JulianDomingo/pcbs/README.md

# pcbs
Public PCB files for my keyboard projects!
