JulianDomingo/pcbs/ai03/pngs/traces.png

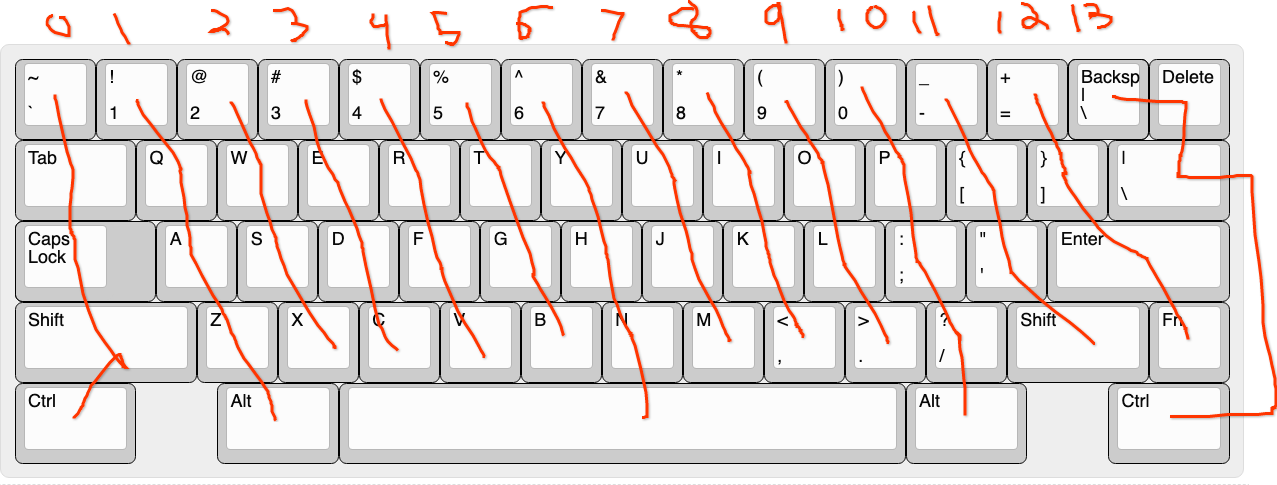
ai03/pngs/traces.png
