JulianDomingo/pcbs/popstar-rp2040/Produce_DanZhi.SMT_Snapshot.Bottom.5732099A_Y2.SMT02303201172969.png

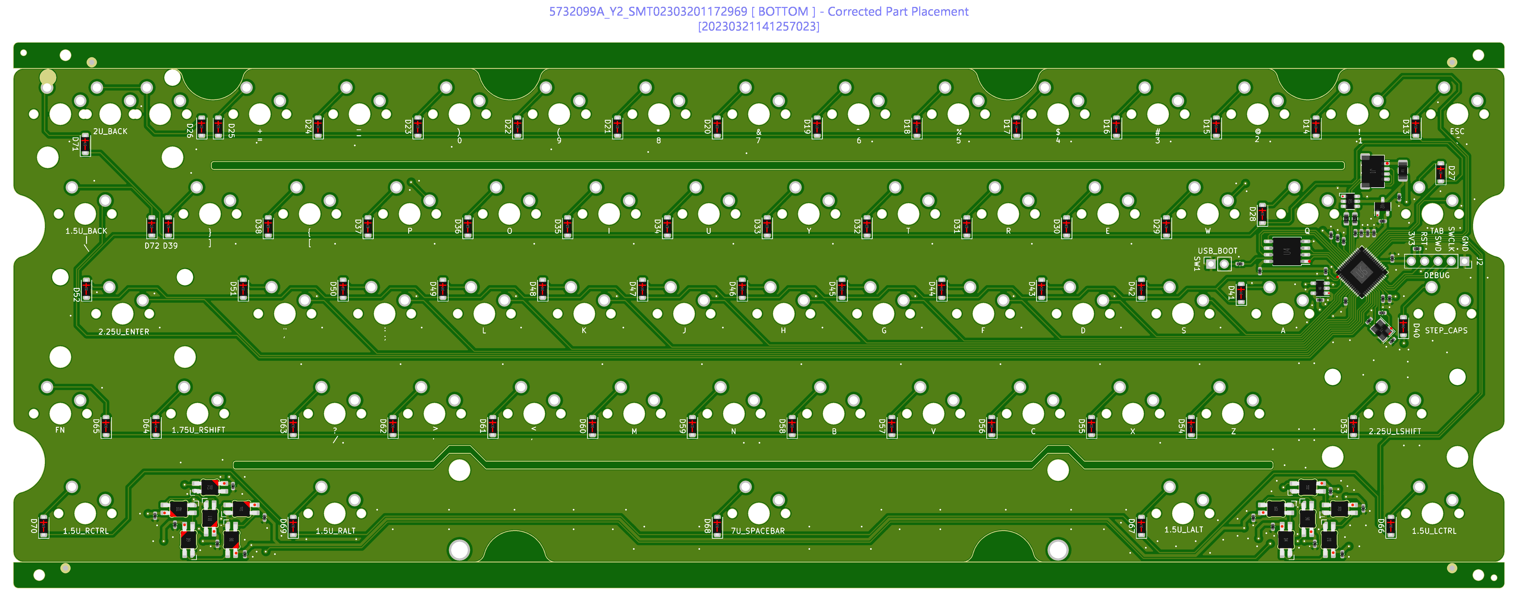
popstar-rp2040/Produce_DanZhi.SMT_Snapshot.Bottom.5732099A_Y2.SMT02303201172969.png
