JulianDomingo/pcbs/popstar-rp2040/Snowball0.png

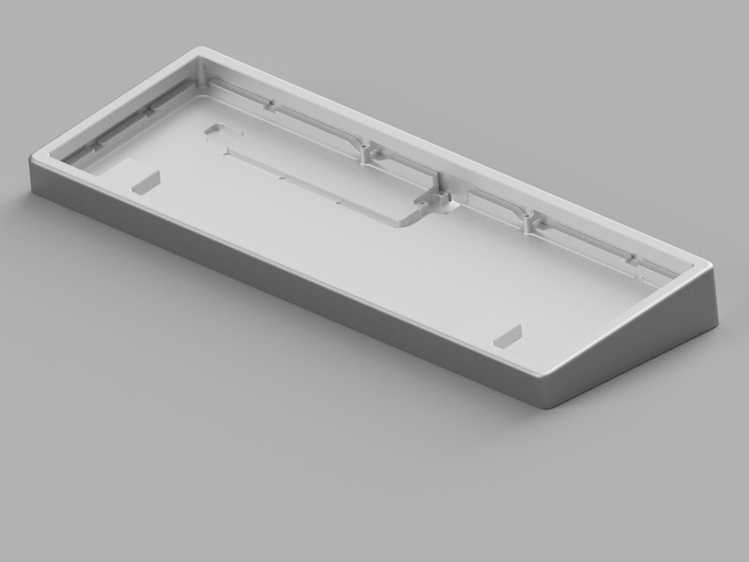
popstar-rp2040/Snowball0.png
