JulianDomingo/pcbs/popstar-rp2040/Snowball1.png

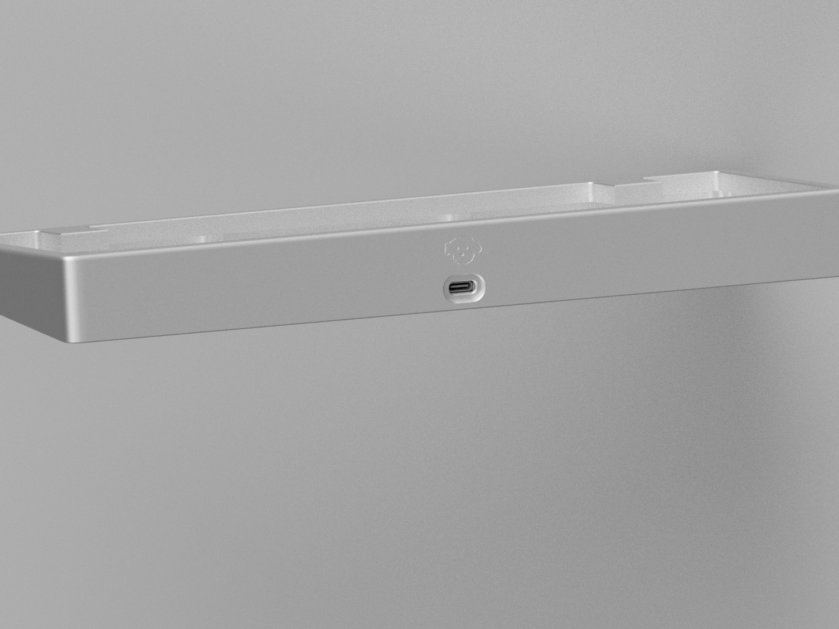
popstar-rp2040/Snowball1.png
