JulianDomingo/pcbs/parts-list/popstar/link.md

[Google Spreadsheet](https://docs.google.com/spreadsheets/d/1XqGUWrDkp94JxGkHds8K1SceW7hPjPMKtQx_E4DiOJU)
