JulianDomingo/pcbs/dxf/engraving.dxf

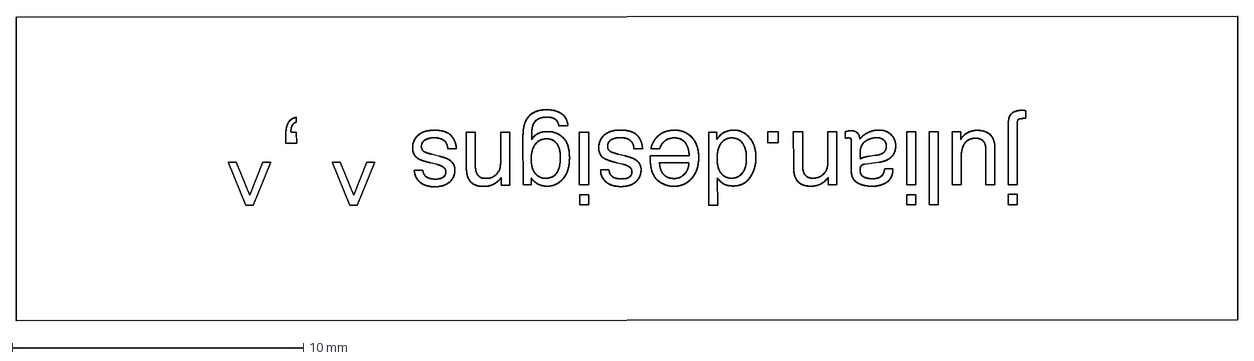
[picture p5: CAD file, 2023-03-19]
dxf/engraving.dxf
42.0 x 10.5 mm
