JulianDomingo/pcbs/popstar-rp2040/uyg.dxf

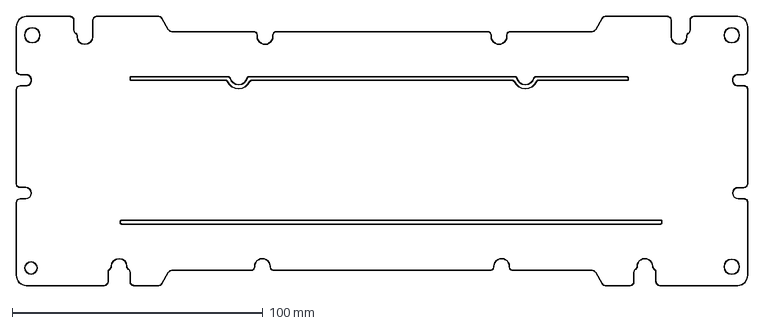
[picture p6: CAD file, 2023-06-08]
popstar-rp2040/uyg.dxf
291.4 x 107.2 mm
