JulianDomingo/pcbs/dxf/bottom_flex_cuts.dxf

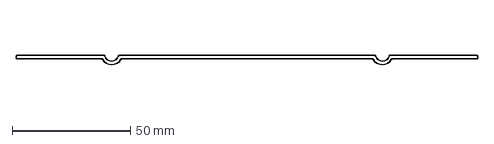
[picture p7: CAD file, 2023-03-12]
dxf/bottom_flex_cuts.dxf
195.0 x 3.97 mm
