JulianDomingo/pcbs/popstar-rp2040/plateless_v4.1_final.dxf

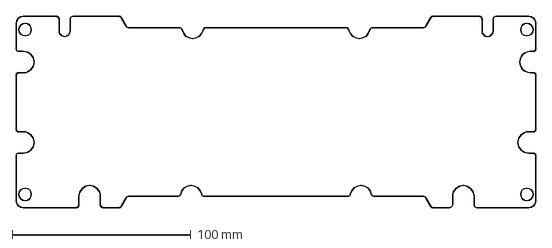
[picture p8: CAD file, 2023-06-08]
popstar-rp2040/plateless_v4.1_final.dxf
290.7 x 107.0 mm
