JulianDomingo/pcbs/dxf/pcb_outer_edges.dxf

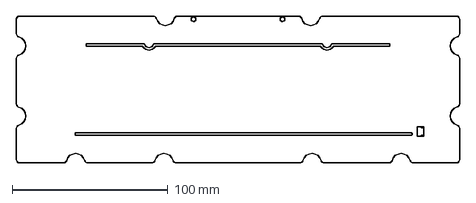
[picture p9: CAD file, 2023-03-12]
dxf/pcb_outer_edges.dxf
284.7 x 94.2 mm
