JulianDomingo/pcbs/popstar-rp2040/popstar_plateless_actual_final.dxf

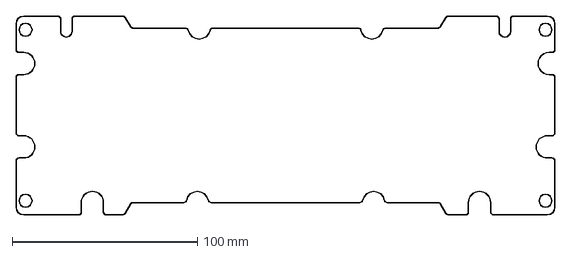
[picture p10: CAD file, 2023-06-08]
popstar-rp2040/popstar_plateless_actual_final.dxf
290.7 x 107.2 mm
