JulianDomingo/pcbs/dxf/pcb_silkscreen.dxf

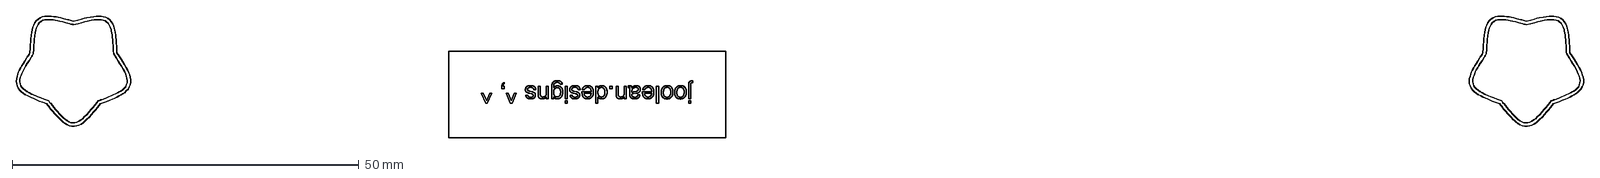
[picture p11: CAD file, 2023-03-10]
dxf/pcb_silkscreen.dxf
226.1 x 17.6 mm
