JulianDomingo/pcbs/popstar-rp2040/no_projections_outline.dxf

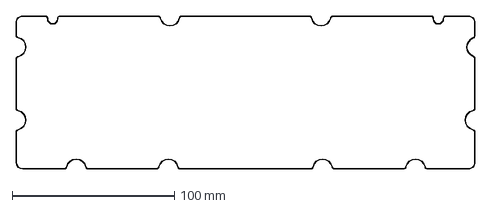
[picture p12: CAD file, 2023-06-08]
popstar-rp2040/no_projections_outline.dxf
282.7 x 94.2 mm
