JulianDomingo/pcbs/popstar-rp2040/popstar_v4.0_plate_outline_final_prod.dxf

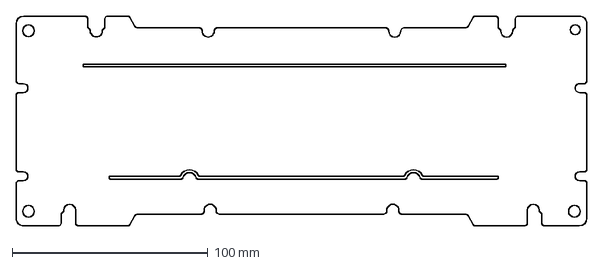
[picture p13: CAD file, 2023-06-08]
popstar-rp2040/popstar_v4.0_plate_outline_final_prod.dxf
291.4 x 107.2 mm
