JulianDomingo/pcbs/popstar-rp2040/popstar_plateless_vertically_aligned.dxf

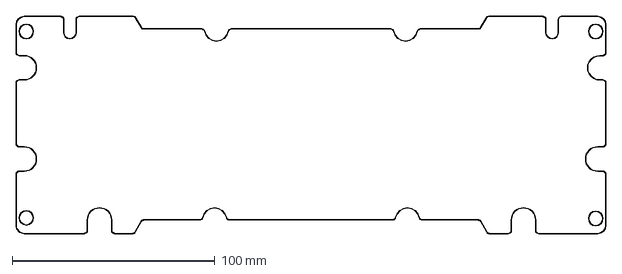
[picture p14: CAD file, 2023-06-08]
popstar-rp2040/popstar_plateless_vertically_aligned.dxf
290.7 x 107.0 mm
