JulianDomingo/pcbs/(list of files, cad)

Other CAD files:
popstar-rp2040/f.silkscreen_no_border.dxf
popstar-rp2040/f.silkscreen_popstarv2.dxf
popstar-rp2040/f.silkscreen_v2.dxf
