JulianDomingo/pcbs/popstar-rp2040/popstar.kicad_pcb

## KiCad design popstar-rp2040/popstar.kicad_pcb (2023-03-16)

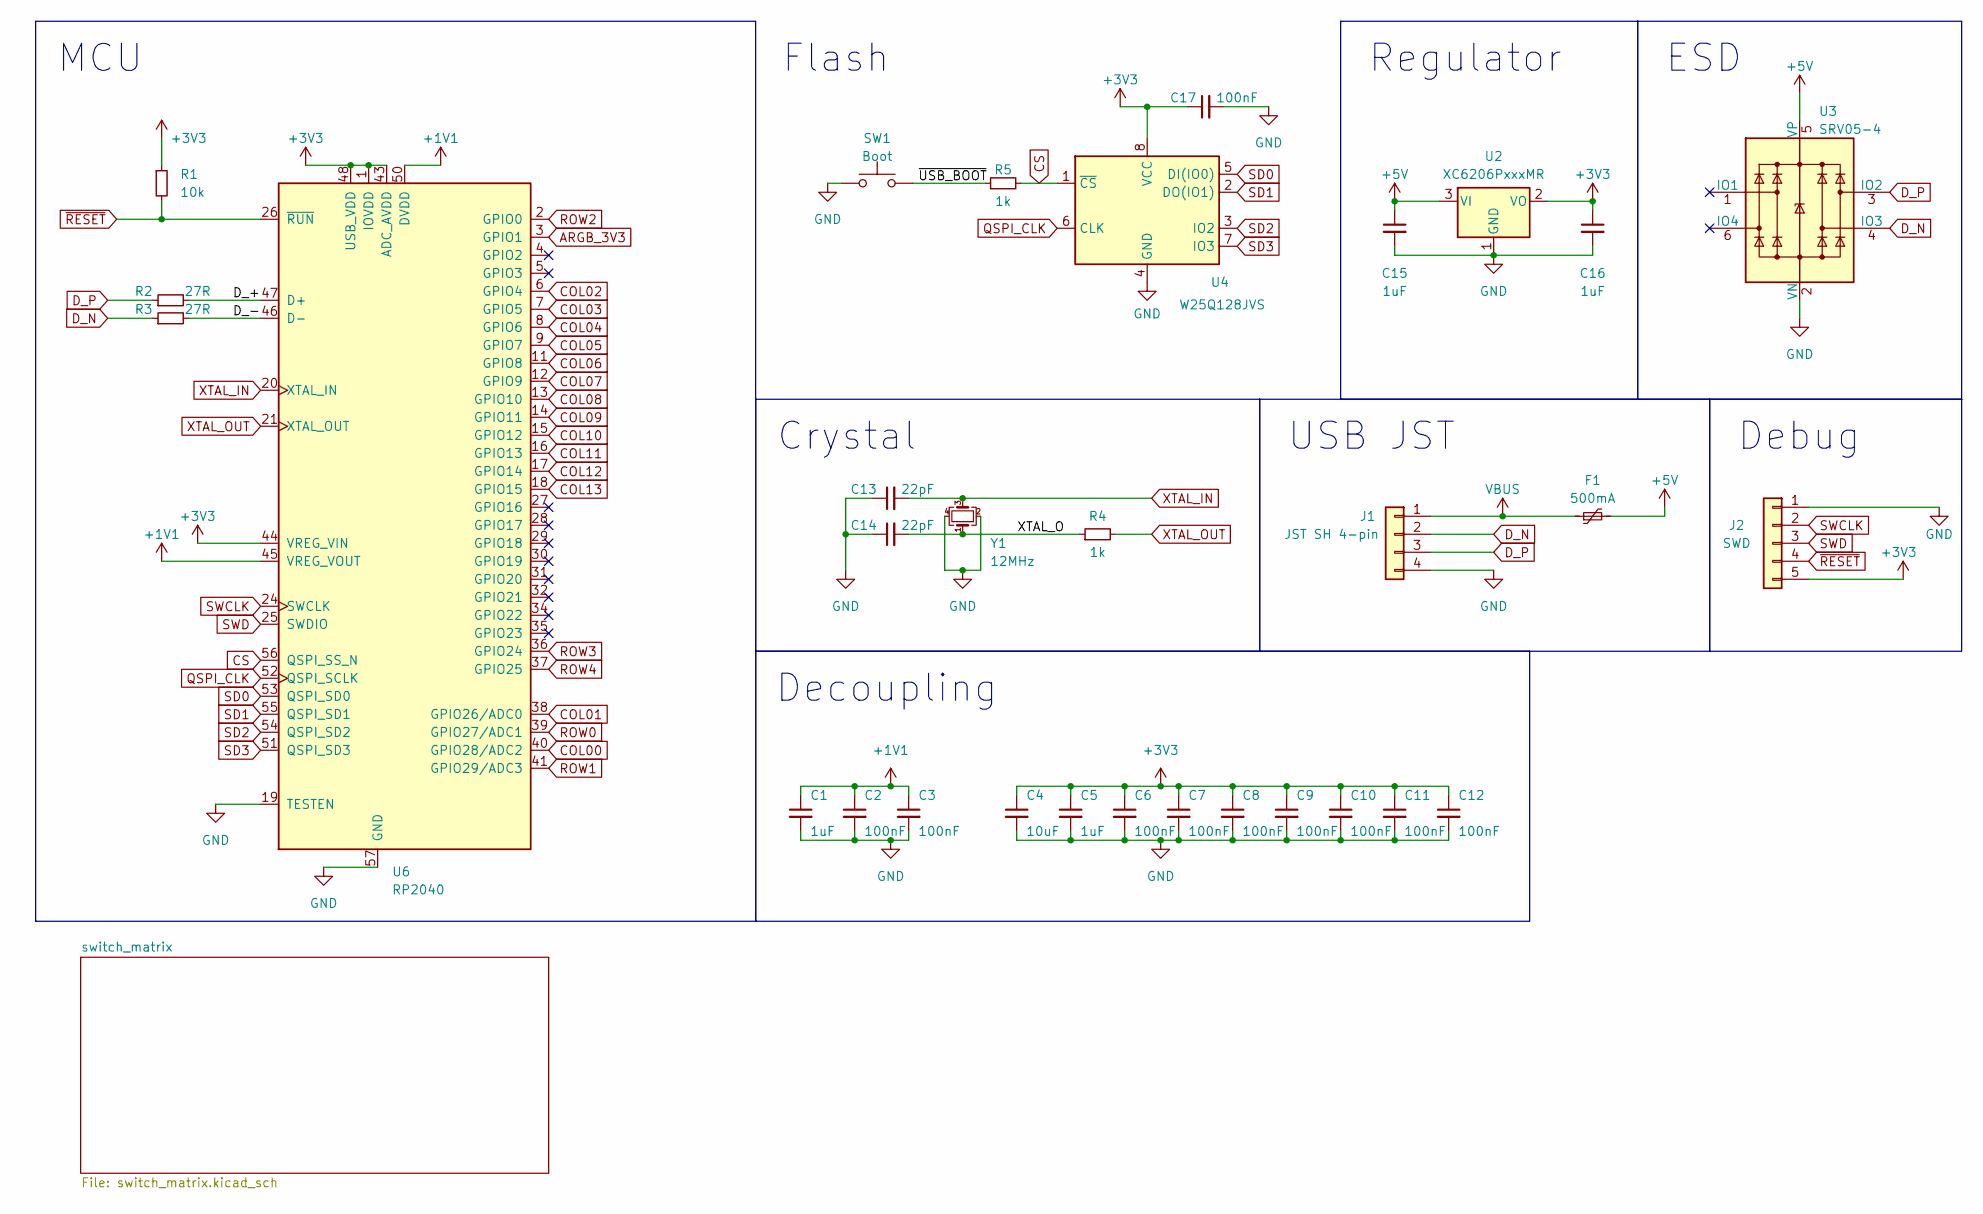
[picture p15: schematic popstar.kicad_sch]

Parts:
C1, C5, C15, C16: 1uF; C_0402_1005Metric; LCSC C52923
C2, C3, C6, C9, C10, C11, C12, C17: 100nF; C_0402_1005Metric; LCSC C1525
C4: 10uF; C_0402_1005Metric; LCSC C15525
C7, C8: 100nF; C_0402_1005Metric; LCSC 1525
C13, C14: 22pF; C_0402_1005Metric; LCSC C1555
F1: 500mA; Fuse_1206_3216Metric; LCSC C135342
J1: JST SH 4-pin; JST_SH_SM04B-SRSS-TB_1x04-1MP_P1.00mm_Horizontal; LCSC C160404
J2: SWD; PinSocket_1x05_P2.54mm_Vertical
R1: 10k; R_0402_1005Metric; LCSC C25744
R2, R3: 27R; R_0603_1608Metric; LCSC C25190
R4, R5: 1k; R_0402_1005Metric; LCSC C11702
SW1: Boot; PinSocket_1x02_P2.54mm_Vertical
U2: XC6206PxxxMR; SOT-23-3; LCSC C5446
U3: SRV05-4; SOT-23-6-routable; LCSC C85364
U4: W25Q128JVS; SOIC-8_5.23x5.23mm_P1.27mm; LCSC C97521
U6: RP2040; RP2040-QFN-56
Y1: 12MHz; Crystal_SMD_3225-4Pin_3.2x2.5mm; LCSC C9002

Connections:
+1V1: C1.1, C2.1, C3.1, U6.23 (DVDD), U6.45 (VREG_VOUT), U6.50 (DVDD)
+3V3: C4.1, C5.1, C6.1, C7.1, C8.1, C9.1, C10.1, C11.1, C12.1, C16.1, C17.1, J2.5, R1.1, U2.2 (VO), U4.8 (VCC), U6.1 (IOVDD), U6.10 (IOVDD), U6.22 (IOVDD), U6.33 (IOVDD), U6.42 (IOVDD), U6.43 (ADC_AVDD), U6.44 (VREG_VIN), U6.48 (USB_VDD), U6.49 (IOVDD)
+5V: C15.1, F1.2, U2.3 (VI), U3.5 (VP); also elsewhere on the board
/D_+: R2.2, U6.47 (D+)
/D_-: R3.2, U6.46 (D-)
/XTAL_O: C14.2, R4.1, Y1.1
/~USB_BOOT: R5.1, SW1.2
ARGB_3V3: U6.3 (GPIO1); also elsewhere on the board
COL00: U6.40 (GPIO28/ADC2); also elsewhere on the board
COL01: U6.38 (GPIO26/ADC0); also elsewhere on the board
COL02: U6.6 (GPIO4); also elsewhere on the board
COL03: U6.7 (GPIO5); also elsewhere on the board
COL04: U6.8 (GPIO6); also elsewhere on the board
COL05: U6.9 (GPIO7); also elsewhere on the board
COL06: U6.11 (GPIO8); also elsewhere on the board
COL07: U6.12 (GPIO9); also elsewhere on the board
COL08: U6.13 (GPIO10); also elsewhere on the board
COL09: U6.14 (GPIO11); also elsewhere on the board
COL10: U6.15 (GPIO12); also elsewhere on the board
COL11: U6.16 (GPIO13); also elsewhere on the board
COL12: U6.17 (GPIO14); also elsewhere on the board
COL13: U6.18 (GPIO15); also elsewhere on the board
CS: R5.2, U4.1 (~CS), U6.56 (QSPI_SS_N)
D_N: J1.2, R3.1, U3.4 (IO3)
D_P: J1.3, R2.1, U3.3 (IO2)
GND: C1.2, C2.2, C3.2, C4.2, C5.2, C6.2, C7.2, C8.2, C9.2, C10.2, C11.2, C12.2, C13.1, C14.1, C15.2, C16.2, C17.2, J1.4, J2.1, SW1.1, U2.1 (GND), U3.2 (VN), U4.4 (GND), U6.19 (TESTEN), U6.57 (GND), Y1.2, Y1.4; also elsewhere on the board
QSPI_CLK: U4.6 (CLK), U6.52 (QSPI_SCLK)
ROW0: U6.39 (GPIO27/ADC1); also elsewhere on the board
ROW1: U6.41 (GPIO29/ADC3); also elsewhere on the board
ROW2: U6.2 (GPIO0); also elsewhere on the board
ROW3: U6.36 (GPIO24); also elsewhere on the board
ROW4: U6.37 (GPIO25); also elsewhere on the board
SD0: U4.5 (DI(IO0)), U6.53 (QSPI_SD0)
SD1: U4.2 (DO(IO1)), U6.55 (QSPI_SD1)
SD2: U4.3 (IO2), U6.54 (QSPI_SD2)
SD3: U4.7 (IO3), U6.51 (QSPI_SD3)
SWCLK: J2.2, U6.24 (SWCLK)
SWD: J2.3, U6.25 (SWDIO)
VBUS: F1.1, J1.1
XTAL_IN: C13.2, U6.20 (XTAL_IN), Y1.3
XTAL_OUT: R4.2, U6.21 (XTAL_OUT)
~RESET: J2.4, R1.2, U6.26 (~RUN)

Notes on the sheet:
MCU
ESD
Regulator
Debug
Crystal
Flash
USB JST
Decoupling

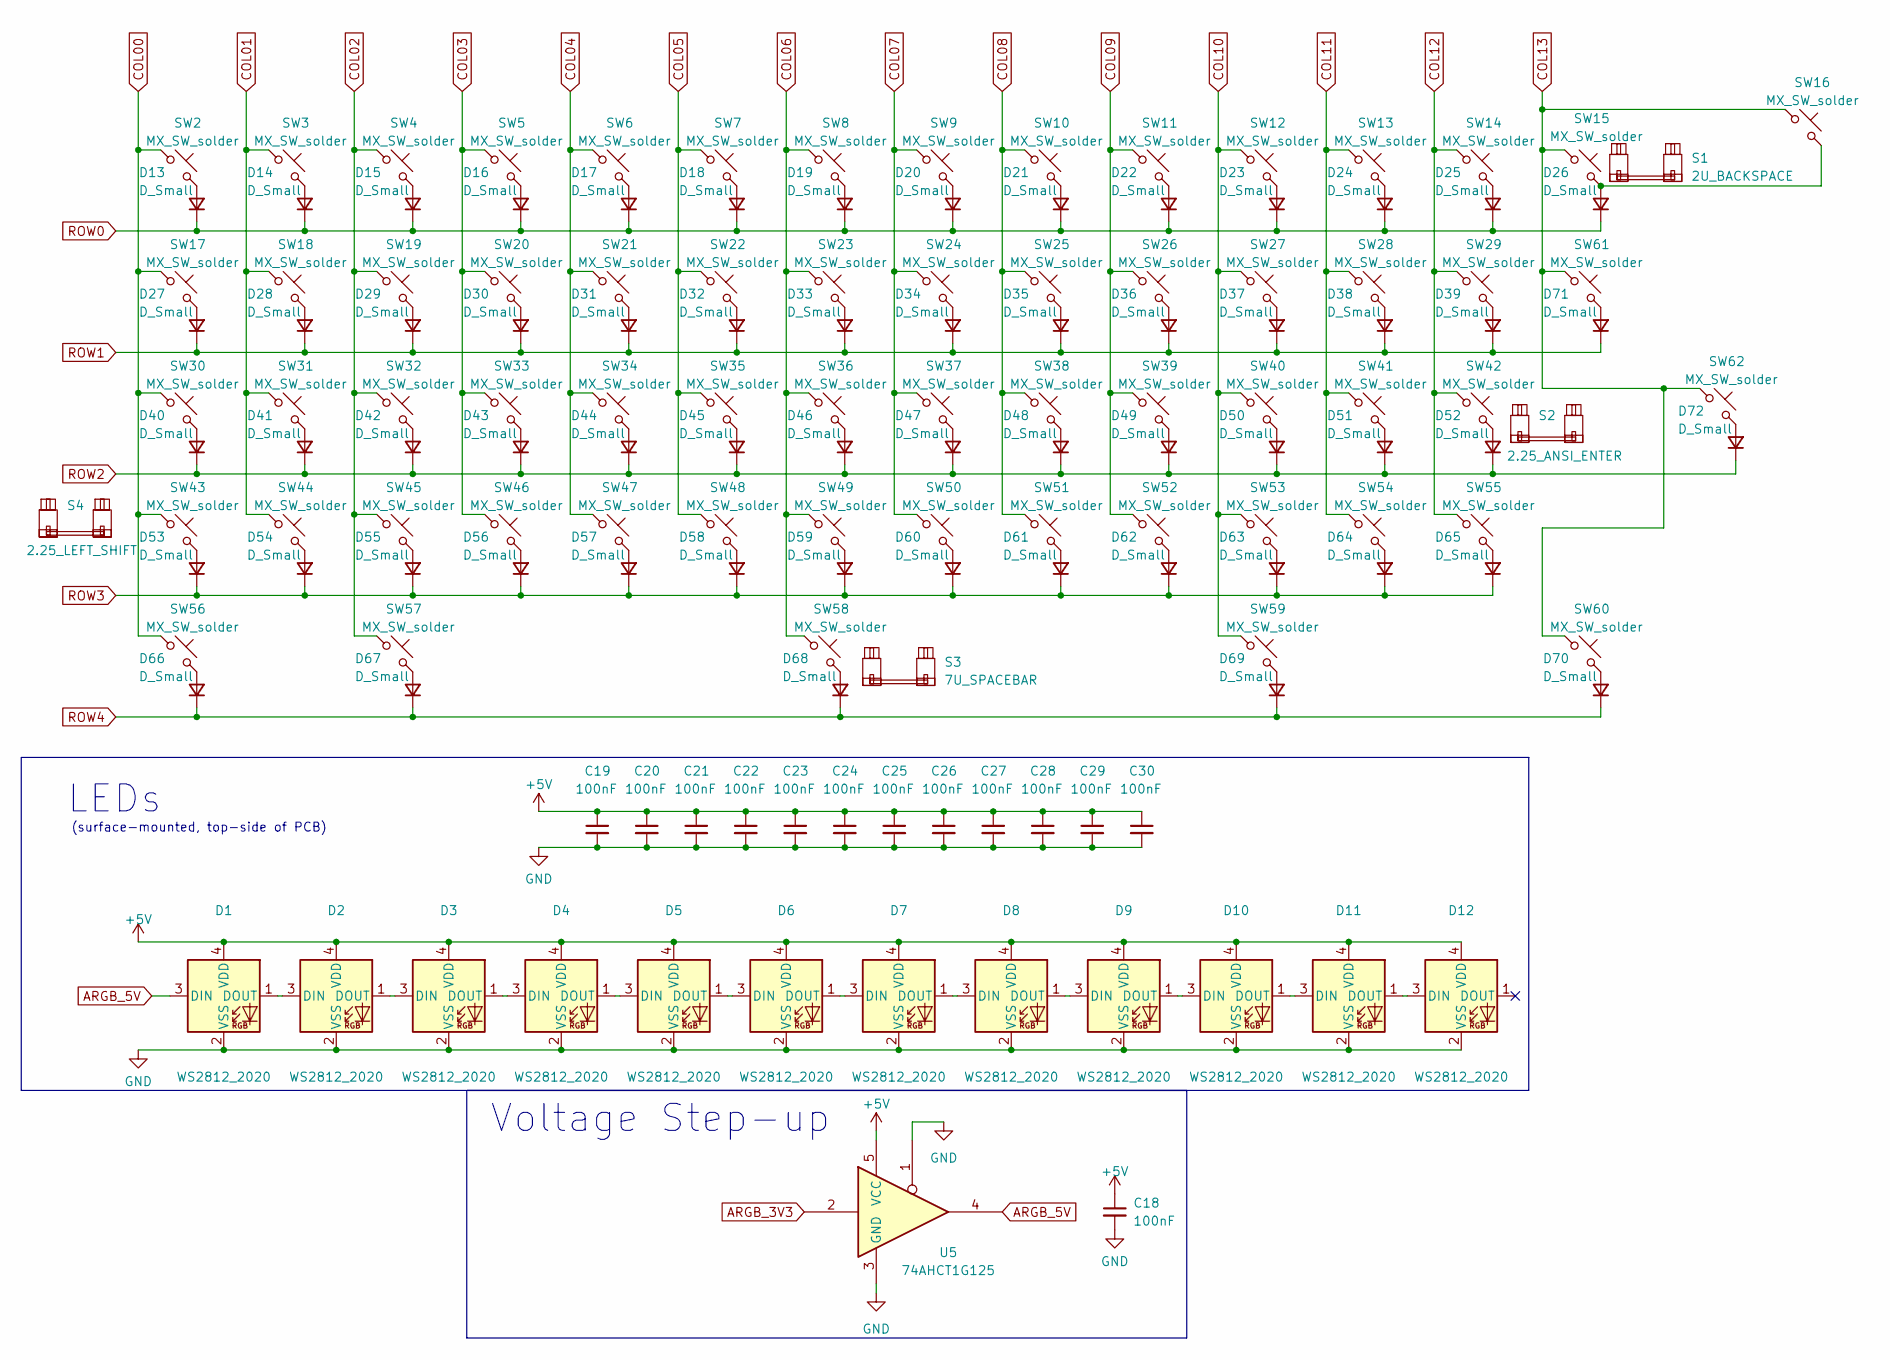
[picture p16: schematic switch_matrix.kicad_sch]

Parts:
C18, C19, C20, C21, C22, C23, C24, C25, C26, C27, C28, C29, C30: 100nF; C_0402_1005Metric; LCSC C1525
D1, D2, D3, D4, D5, D6, D7, D8, D9, D10, D11, D12: WS2812_2020; LED_WS2812_2020
D13, D14, D15, D16, D17, D18, D19, D20, D21, D22, D23, D24, D25, D26, D27, D28, D29, D30, D31, D32, D33, D34, D35, D36, D37, D38, D39, D40, D41, D42, D43, D44, D45, D46, D47, D48, D49, D50, D51, D52, D53, D54, D55, D56, D57, D58, D59, D60, D61, D62, D63, D64, D65, D66, D67, D68, D69, D70, D71, D72: D_Small; D_SOD-123; LCSC C81598
S1: 2U_BACKSPACE; STAB_MX_2u
S2: 2.25_ANSI_ENTER; STAB_MX_2.25u
S3: 7U_SPACEBAR; STAB_MX_P_7u
S4: 2.25_LEFT_SHIFT; STAB_MX_2.25u
SW2, SW3, SW4, SW5, SW6, SW7, SW8, SW9, SW10, SW11, SW12, SW13, SW14, SW15, SW16, SW18, SW19, SW20, SW21, SW22, SW23, SW24, SW25, SW26, SW27, SW28, SW29, SW31, SW32, SW33, SW34, SW35, SW36, SW37, SW38, SW39, SW40, SW41, SW42, SW43, SW44, SW45, SW46, SW47, SW48, SW49, SW50, SW51, SW52, SW53, SW55, SW58, SW61: MX_SW_solder; SW_MX_1u
SW17, SW56, SW57, SW59, SW60, SW62: MX_SW_solder; SW_MX_1.5u
SW30: MX_SW_solder; SW_MX_1.75u_stp
SW54: MX_SW_solder; SW_MX_1.75u
U5: 74AHCT1G125; SOT-23-5; LCSC C7484

Connections:
+5V: C18.1, C19.1, C20.1, C21.1, C22.1, C23.1, C24.1, C25.1, C26.1, C27.1, C28.1, C29.1, C30.1, D1.4 (VDD), D2.4 (VDD), D3.4 (VDD), D4.4 (VDD), D5.4 (VDD), D6.4 (VDD), D7.4 (VDD), D8.4 (VDD), D9.4 (VDD), D10.4 (VDD), D11.4 (VDD), D12.4 (VDD), U5.5 (VCC); also elsewhere on the board
ARGB_3V3: U5.2; also elsewhere on the board
ARGB_5V: D1.3 (DIN), U5.4
COL00: SW2.1, SW17.1, SW30.1, SW43.1, SW56.1; also elsewhere on the board
COL01: SW3.1, SW18.1, SW31.1, SW44.1; also elsewhere on the board
COL02: SW4.1, SW19.1, SW32.1, SW45.1, SW57.1; also elsewhere on the board
COL03: SW5.1, SW20.1, SW33.1, SW46.1; also elsewhere on the board
COL04: SW6.1, SW21.1, SW34.1, SW47.1; also elsewhere on the board
COL05: SW7.1, SW22.1, SW35.1, SW48.1; also elsewhere on the board
COL06: SW8.1, SW23.1, SW36.1, SW49.1, SW58.1; also elsewhere on the board
COL07: SW9.1, SW24.1, SW37.1, SW50.1; also elsewhere on the board
COL08: SW10.1, SW25.1, SW38.1, SW51.1; also elsewhere on the board
COL09: SW11.1, SW26.1, SW39.1, SW52.1; also elsewhere on the board
COL10: SW12.1, SW27.1, SW40.1, SW53.1, SW59.1; also elsewhere on the board
COL11: SW13.1, SW28.1, SW41.1, SW54.1; also elsewhere on the board
COL12: SW14.1, SW29.1, SW42.1, SW55.1; also elsewhere on the board
COL13: SW15.1, SW16.1, SW60.1, SW61.1, SW62.1; also elsewhere on the board
GND: C18.2, C19.2, C20.2, C21.2, C22.2, C23.2, C24.2, C25.2, C26.2, C27.2, C28.2, C29.2, C30.2, D1.2 (VSS), D2.2 (VSS), D3.2 (VSS), D4.2 (VSS), D5.2 (VSS), D6.2 (VSS), D7.2 (VSS), D8.2 (VSS), D9.2 (VSS), D10.2 (VSS), D11.2 (VSS), D12.2 (VSS), U5.1, U5.3 (GND); also elsewhere on the board
unnamed: D1.1 (DOUT), D2.3 (DIN)
unnamed: D2.1 (DOUT), D3.3 (DIN)
unnamed: D3.1 (DOUT), D4.3 (DIN)
unnamed: D4.1 (DOUT), D5.3 (DIN)
unnamed: D5.1 (DOUT), D6.3 (DIN)
unnamed: D6.1 (DOUT), D7.3 (DIN)
unnamed: D7.1 (DOUT), D8.3 (DIN)
unnamed: D8.1 (DOUT), D9.3 (DIN)
unnamed: D9.1 (DOUT), D10.3 (DIN)
unnamed: D10.1 (DOUT), D11.3 (DIN)
unnamed: D11.1 (DOUT), D12.3 (DIN)
unnamed: D13.2 (A), SW2.2
unnamed: D14.2 (A), SW3.2
unnamed: D15.2 (A), SW4.2
unnamed: D16.2 (A), SW5.2
unnamed: D17.2 (A), SW6.2
unnamed: D18.2 (A), SW7.2
unnamed: D19.2 (A), SW8.2
unnamed: D20.2 (A), SW9.2
unnamed: D21.2 (A), SW10.2
unnamed: D22.2 (A), SW11.2
unnamed: D23.2 (A), SW12.2
unnamed: D24.2 (A), SW13.2
unnamed: D25.2 (A), SW14.2
unnamed: D26.2 (A), SW15.2, SW16.2
unnamed: D27.2 (A), SW17.2
unnamed: D28.2 (A), SW18.2
unnamed: D29.2 (A), SW19.2
unnamed: D30.2 (A), SW20.2
unnamed: D31.2 (A), SW21.2
unnamed: D32.2 (A), SW22.2
unnamed: D33.2 (A), SW23.2
unnamed: D34.2 (A), SW24.2
unnamed: D35.2 (A), SW25.2
unnamed: D36.2 (A), SW26.2
unnamed: D37.2 (A), SW27.2
unnamed: D38.2 (A), SW28.2
unnamed: D39.2 (A), SW29.2
unnamed: D40.2 (A), SW30.2
unnamed: D41.2 (A), SW31.2
unnamed: D42.2 (A), SW32.2
unnamed: D43.2 (A), SW33.2
unnamed: D44.2 (A), SW34.2
unnamed: D45.2 (A), SW35.2
unnamed: D46.2 (A), SW36.2
unnamed: D47.2 (A), SW37.2
unnamed: D48.2 (A), SW38.2
unnamed: D49.2 (A), SW39.2
unnamed: D50.2 (A), SW40.2
unnamed: D51.2 (A), SW41.2
unnamed: D52.2 (A), SW42.2
unnamed: D53.2 (A), SW43.2
unnamed: D54.2 (A), SW44.2
unnamed: D55.2 (A), SW45.2
unnamed: D56.2 (A), SW46.2
unnamed: D57.2 (A), SW47.2
unnamed: D58.2 (A), SW48.2
unnamed: D59.2 (A), SW49.2
unnamed: D60.2 (A), SW50.2
unnamed: D61.2 (A), SW51.2
unnamed: D62.2 (A), SW52.2
unnamed: D63.2 (A), SW53.2
unnamed: D64.2 (A), SW54.2
unnamed: D65.2 (A), SW55.2
unnamed: D66.2 (A), SW56.2
unnamed: D67.2 (A), SW57.2
unnamed: D68.2 (A), SW58.2
unnamed: D69.2 (A), SW59.2
unnamed: D70.2 (A), SW60.2
unnamed: D71.2 (A), SW61.2
unnamed: D72.2 (A), SW62.2
ROW0: D13.1 (K), D14.1 (K), D15.1 (K), D16.1 (K), D17.1 (K), D18.1 (K), D19.1 (K), D20.1 (K), D21.1 (K), D22.1 (K), D23.1 (K), D24.1 (K), D25.1 (K), D26.1 (K); also elsewhere on the board
ROW1: D27.1 (K), D28.1 (K), D29.1 (K), D30.1 (K), D31.1 (K), D32.1 (K), D33.1 (K), D34.1 (K), D35.1 (K), D36.1 (K), D37.1 (K), D38.1 (K), D39.1 (K), D71.1 (K); also elsewhere on the board
ROW2: D40.1 (K), D41.1 (K), D42.1 (K), D43.1 (K), D44.1 (K), D45.1 (K), D46.1 (K), D47.1 (K), D48.1 (K), D49.1 (K), D50.1 (K), D51.1 (K), D52.1 (K), D72.1 (K); also elsewhere on the board
ROW3: D53.1 (K), D54.1 (K), D55.1 (K), D56.1 (K), D57.1 (K), D58.1 (K), D59.1 (K), D60.1 (K), D61.1 (K), D62.1 (K), D63.1 (K), D64.1 (K), D65.1 (K); also elsewhere on the board
ROW4: D66.1 (K), D67.1 (K), D68.1 (K), D69.1 (K), D70.1 (K); also elsewhere on the board

Notes on the sheet:
(surface-mounted, top-side of PCB)
LEDs
Voltage Step-up

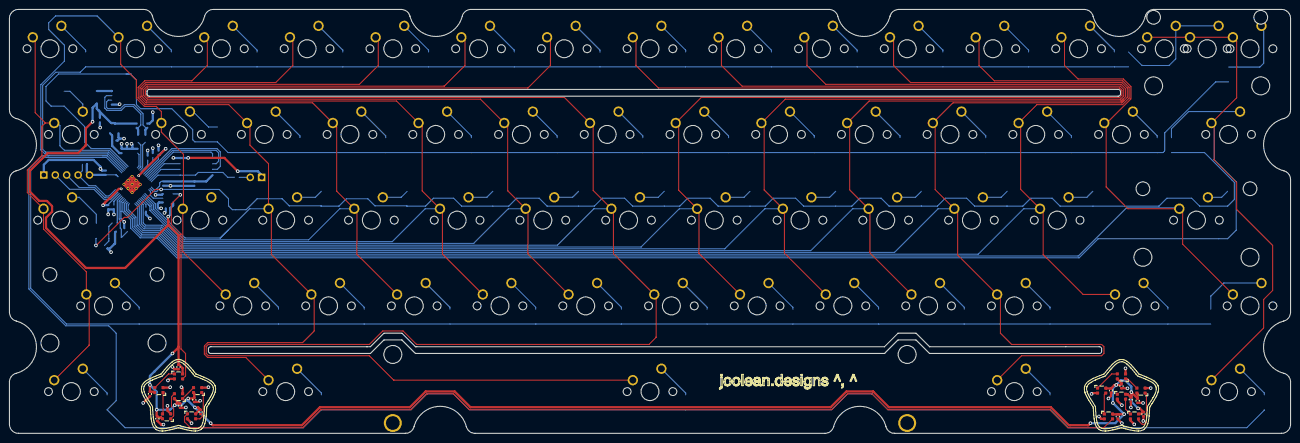
[picture p17: board popstar.kicad_pcb from above]

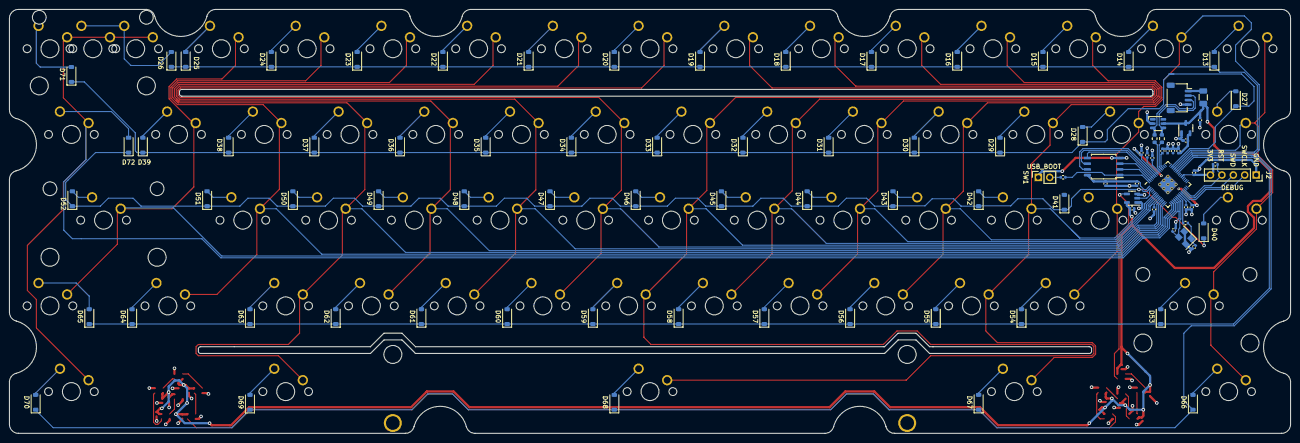
[picture p18: board popstar.kicad_pcb from below]

Board: 2 copper layers, 284.7 x 94.2 mm, 182 parts (93 on the bottom side), 114 nets.
