JulianDomingo/pcbs/(commit log)

2023-02-25 Add popstar dir, submodules for MX footprints + usb connectors
    [audio.kicad_pcb, audio.kicad_sch]
2023-02-25 Added footprint libraries, updated dir structure
    [popstar.kicad_pcb, popstar.kicad_sch]
2023-02-26 Added KLE for popstar + gitignore file
    [popstar.kicad_sch]
2023-02-26 Added outline for switch footprints / dimensions + KLE json
    [pcb_outline.dxf]
2023-02-26 Added planned traces for schematic
2023-02-26 Rearranged directories
    [popstar.kicad_pcb, popstar.kicad_sch]
2023-02-26 Added RP2040 version of popstar (branched from ice60)
    [ice60.kicad_sch, matrix.kicad_sch, popstar-rp2040.kicad_pcb, popstar-rp2040.kicad_sch, popstar.kicad_sch]
2023-02-26 Repurposed 'popstar' to be ai03 tutorial. Real popstar PCB design will be in rp2040 folder.
    [ai03.kicad_pcb, ai03.kicad_sch]
2023-02-26 Added notes on decoupling capacitors, small progress on ai03 guide
2023-02-26 Renamed popstar-rp2040 => reference rp2040. Created an actual dir for popstar rp2040 design.
    [ai03.kicad_sch, ice60.kicad_sch, matrix.kicad_sch, popstar-rp2040.kicad_pcb, popstar-rp2040.kicad_sch]
2023-02-27 Added circuitry schematics for RP2040 popstar, excluding switch matrix and LEDs
    [popstar.kicad_pcb, popstar.kicad_sch, switch_matrix.kicad_sch]
2023-03-05 Added surface-mounted LEDs for shinethrough on WKL blockers.
    [switch_matrix.kicad_sch]
2023-03-05 Cleaned up LED schematic impl.
    [popstar.kicad_sch, switch_matrix.kicad_sch]
2023-03-06 Added BOM spreadsheet, updated components with LCSC part numbers and footprints.
    [popstar.kicad_sch, switch_matrix.kicad_sch]
2023-03-06 Finished switch matrix, updated pin connections accordingly
    [popstar.kicad_sch, switch_matrix.kicad_sch]
2023-03-07 Fixed missing footprints in schematic, added barfed out components in PCB editor. Properly connected sleep-lib symbol libraries into popstar project.
    [popstar.kicad_pcb, popstar.kicad_sch]
2023-03-08 Correct 2.25 left shift to use 2.25 stab footprint
    [popstar.kicad_pcb, switch_matrix.kicad_sch]
2023-03-09 Placed switch, stabs, and diode components in the proper places.
    [popstar.kicad_pcb]
2023-03-09 Placed crystal oscillator components in the proper places.
    [popstar.kicad_pcb]
2023-03-10 Added edge cuts, front silkscreen, adjusted diodes to not interfere with edge cuts
    [pcb_outer_edges.dxf, pcb_silkscreen.dxf, popstar.kicad_pcb, popstar_pcb_outline.dxf]
2023-03-10 Removed silkscreen near MCU + silkscreen collision with star LEDs
    [popstar.kicad_pcb]
2023-03-10 Added more decoupling capacitors near MCU, debug, cleaned up component positioning a bit
    [popstar.kicad_pcb]
2023-03-10 Removed F.Cu + 3D connector for debug/boot, corrected through-holes for 7u stab
    [popstar.kicad_pcb]
2023-03-11 Finished placing all components within the courtyard.
    [popstar.kicad_pcb, popstar.kicad_sch, switch_matrix.kicad_sch]
2023-03-11 Added default trace widths, added routing for some of the decoupling caps
    [popstar.kicad_pcb]
2023-03-11 Tweaked JST position to align fully with H60
    [pcb_outer_edges.dxf, pcb_outline.dxf, popstar.kicad_pcb, popstar_pcb_outline.dxf]
2023-03-11 Routed debug
    [popstar.kicad_pcb, popstar.kicad_sch]
2023-03-12 Routed crystal oscillator, changed up GPIO pins for cleaner switch matrix routing
    [popstar.kicad_pcb, popstar.kicad_sch]
2023-03-12 Fixed routing issue on one of the decoupling caps, increased traces from MCU to 0.20mm
    [popstar.kicad_pcb]
2023-03-12 Routed JST connector, ESD, voltage regulator, and more decoupling caps.
    [popstar.kicad_pcb]
2023-03-12 Routed remainder of decoupling caps.
    [popstar.kicad_pcb]
2023-03-12 Routed flash, boot
    [popstar.kicad_pcb]
2023-03-12 Properly connected diodes to switches in the schematic
    [popstar.kicad_pcb, switch_matrix.kicad_sch]
2023-03-12 Finished routing rows, cleaned up existing traces. Switched row0 and col0 for cleaner routing.
    [popstar.kicad_pcb, popstar.kicad_sch]
2023-03-12 Further removed some duplicate, unconnected traces
    [popstar.kicad_pcb]
2023-03-12 Fixed all DRC errors unrelated to split BS
    [bottom_flex_cuts.dxf, pcb_outer_edges.dxf, popstar.kicad_pcb]
2023-03-12 Updated traces near voltage step up component
    [popstar.kicad_pcb]
2023-03-12 Repositioned row 2 diodes for proper routing of switch matrix columns
    [popstar.kicad_pcb]
2023-03-13 Fixed footprint mismatch for stabs
    [popstar.kicad_pcb, switch_matrix.kicad_sch]
2023-03-13 Fixed remainder of mismatched footprints. Simply did 'Change Footprint', but used the same name.
    [popstar.kicad_pcb]
2023-03-13 Fixed more DRC errors, routed columns, added front Cu on GND pins for MCU
    [popstar.kicad_pcb]
2023-03-13 Finished routing columns for rows 2, 3, 4
    [popstar.kicad_pcb]
2023-03-13 Finshed routing columns for row 5
    [popstar.kicad_pcb]
2023-03-13 Finished routing columns for row 1
    [popstar.kicad_pcb]
2023-03-13 Changed column trace to front for right ctrl
    [popstar.kicad_pcb]
2023-03-13 Removed f.mask from debug and boot + extraneous kicad components
    [popstar.kicad_pcb]
2023-03-13 Reinstated f.mask and extraneous components for flash and boot to suppress DRC warnings. Fixed remainder of trace DRC errors.
    [popstar.kicad_pcb]
2023-03-13 Started out routing for step up voltage
    [popstar.kicad_pcb]
2023-03-13 Repositioned star LEDs for more convenient routing, WIP
    [fuyu.kicad_sch, popstar.kicad_pcb]
2023-03-16 Finished up routing for left star blocker, moved one of the 3V3 decoupling capacitors closer to MCU
    [popstar.kicad_pcb]
2023-03-16 Routed right star blocker, fixed non-GND VIA DRC warnings
    [popstar.kicad_pcb]
2023-03-18 Added F.Cu and B.Cu ground fills, cleaned p DRC violations
2023-03-19 Cleaned up GND stitching for 5V
2023-03-19 Cleaned up GND via stitching again
2023-03-19 Added back silkscreen for key indicators, additinoal GND stitching vias for assurance
    [engraving.dxf]
2023-03-19 Added LCSC part for LEDs, gerber files for prod
    [popstar-B_Cu.gbl, popstar-B_Mask.gbs, popstar-B_Paste.gbp, popstar-B_Silkscreen.gbo, popstar-Edge_Cuts.gm1, popstar-F_Cu.gtl, popstar-F_Mask.gts, popstar-F_Paste.gtp]
2023-03-19 Updated LEDs to use SK6812MINI-E (rev mount) in schematic. PCB design update WIP.
    [switch_matrix.kicad_sch]
2023-03-19 Finished re-design for left blocker LEDs
2023-03-19 Finished routing to the right LED blocker
2023-03-20 Removed star F.Silkscreen to remove DRC warnings, cleaned up rest of DRC violations from new LED routing
2023-03-20 Updated production files
    [popstar-B_Cu.gbl, popstar-B_Mask.gbs, popstar-B_Paste.gbp, popstar-B_Silkscreen.gbo, popstar-Edge_Cuts.gm1, popstar-F_Cu.gtl, popstar-F_Mask.gts, popstar-F_Paste.gtp]
2023-03-20 Used unedit footprints for LEDs
    [popstar-B_Cu.gbl, popstar-B_Mask.gbs, popstar-B_Paste.gbp, popstar-B_Silkscreen.gbo, popstar-Edge_Cuts.gm1, popstar-F_Cu.gtl, popstar-F_Mask.gts, popstar-F_Paste.gtp]
2023-03-20 Attempting to get rid of annoying resurfacing DRC warnings related to footprints
    [popstar-B_Cu.gbl, popstar-B_Mask.gbs, popstar-B_Paste.gbp, popstar-B_Silkscreen.gbo, popstar-Edge_Cuts.gm1, popstar-F_Cu.gtl, popstar-F_Mask.gts, popstar-F_Paste.gtp]
2023-05-06 First v2 pcb commit, updated edge cut dimensions and rerouted traces to accommodate it.
    [popstar-B_Cu.gbl, popstar-B_Mask.gbs, popstar-B_Paste.gbp, popstar-B_Silkscreen.gbo, popstar-Edge_Cuts.gm1, popstar-F_Cu.gtl, popstar-F_Mask.gts, popstar-F_Paste.gtp]
2023-05-06 Changed primary JST location to center of PCB (between U and Y key), rerouted traces accordingly.
2023-05-07 Fixed unconnected trace ends, updated f.silkscreen
    [f.silkscreen_no_border.dxf, f.silkscreen_popstarv2.dxf, f.silkscreen_v2.dxf]
2023-06-08 oh god I haven't committed in over 3 months
    [BOM-popstar_plateless_with_flex_cuts.csv, no_projections_outline.dxf, plateless_v4.1_final.dxf, pleaseeeeeeeee.dxf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]
