JulianDomingo/pcbs/(notices)

Notices in the files:
rp2040-reference/ice60.kicad_sch:
© 2022 chillKB
CERN Open Hardware License version 2 -- Permissive
